adrian-dobre/Nano33IoT-Electra-Intercom/board/pcb/etch/Intercom_etch_copper_bottom.pdf

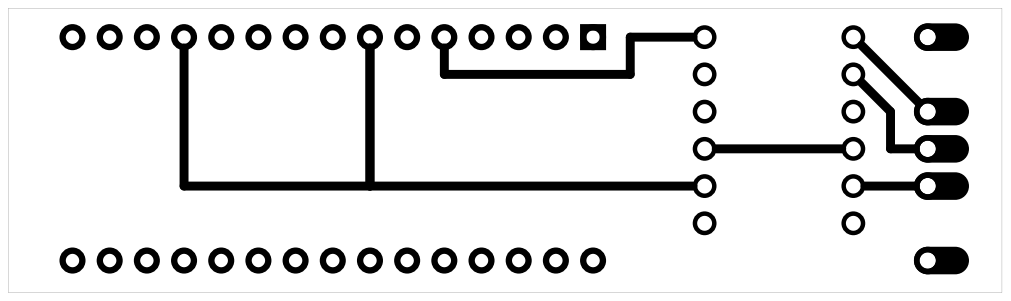
[picture p10: page 1]
