adrian-dobre/Nano33IoT-Electra-Intercom/board/pcb/etch/Intercom_etch_copper_bottom_mirror.pdf

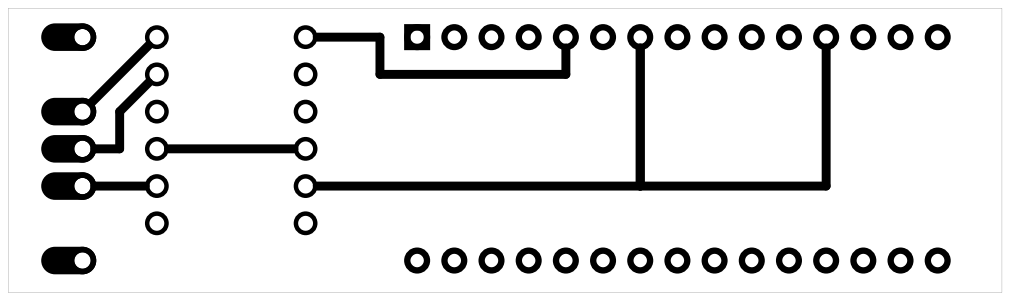
[picture p11: page 1]
