adrian-dobre/Nano33IoT-Electra-Intercom/board/pcb/etch/Intercom_etch_copper_top.pdf

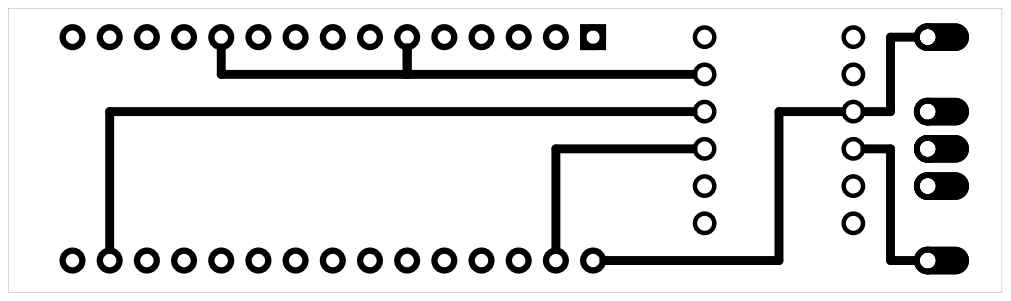
[picture p12: page 1]
