adrian-dobre/Nano33IoT-Electra-Intercom/board/pcb/etch/Intercom_etch_copper_top_mirror.pdf

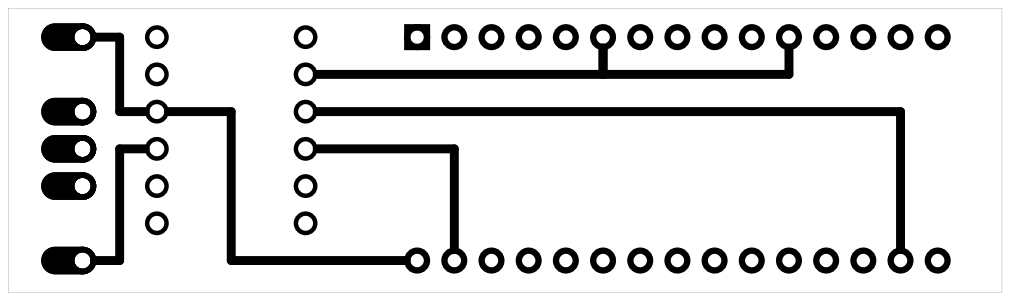
[picture p13: page 1]
