adrian-dobre/Nano33IoT-Electra-Intercom/board/pcb/etch/Intercom_etch_mask_bottom.pdf

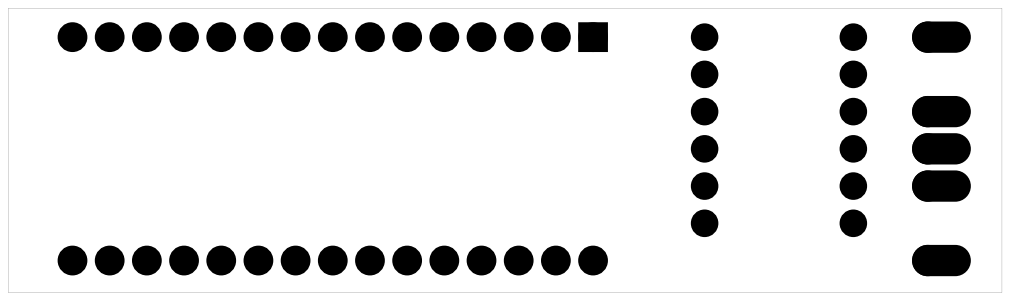
[picture p14: page 1]
