adrian-dobre/Nano33IoT-Electra-Intercom/board/pcb/etch/Intercom_etch_mask_bottom_mirror.pdf

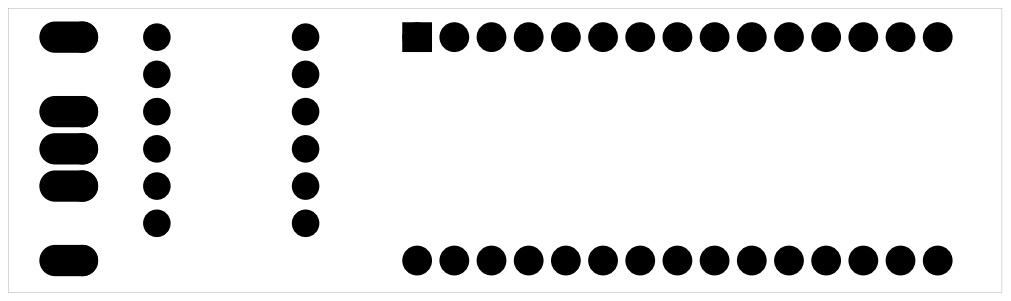
[picture p15: page 1]
