adrian-dobre/Nano33IoT-Electra-Intercom/board/pcb/etch/Intercom_etch_mask_top.pdf

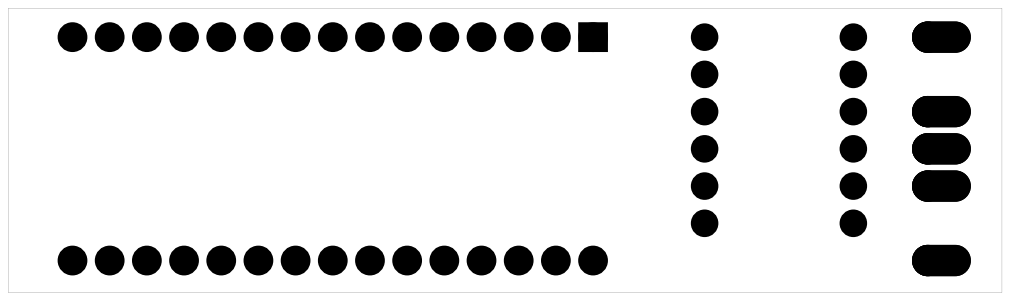
[picture p16: page 1]
