adrian-dobre/Nano33IoT-Electra-Intercom/board/pcb/etch/Intercom_etch_mask_top_mirror.pdf

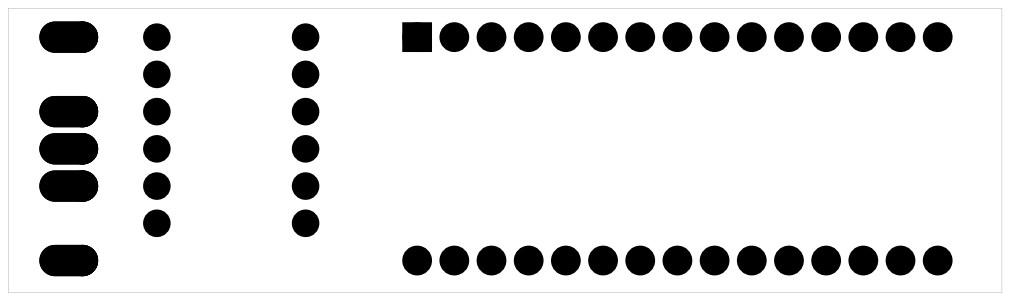
[picture p17: page 1]
