adrian-dobre/Nano33IoT-Electra-Intercom/board/pcb/etch/Intercom_etch_silk_bottom.pdf

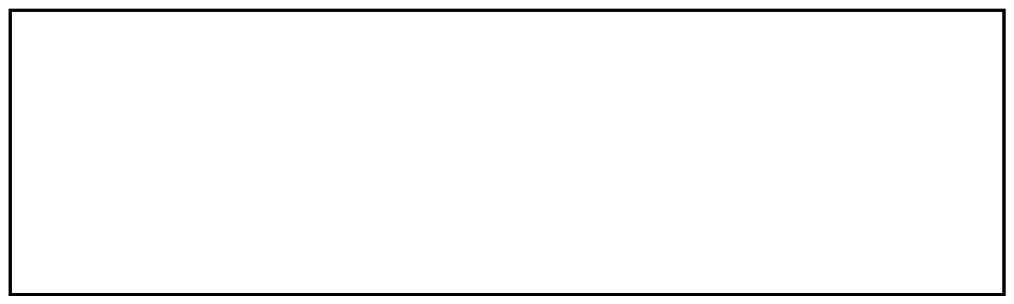
[picture p18: page 1]
