adrian-dobre/Nano33IoT-Electra-Intercom/board/pcb/etch/Intercom_etch_silk_bottom_mirror.pdf

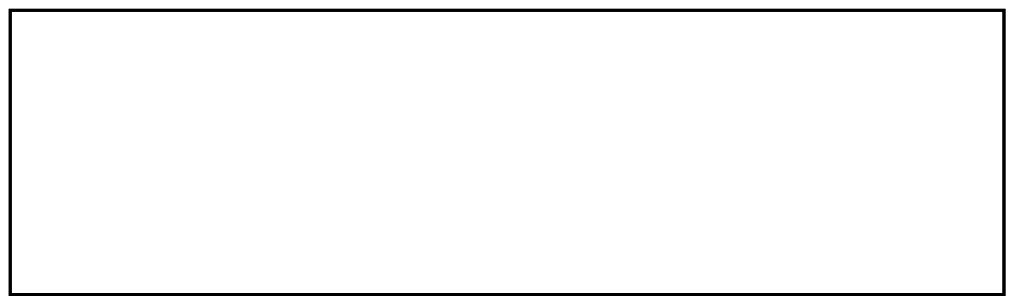
[picture p19: page 1]
