adrian-dobre/Nano33IoT-Electra-Intercom/board/pcb/etch/Intercom_etch_silk_top.pdf

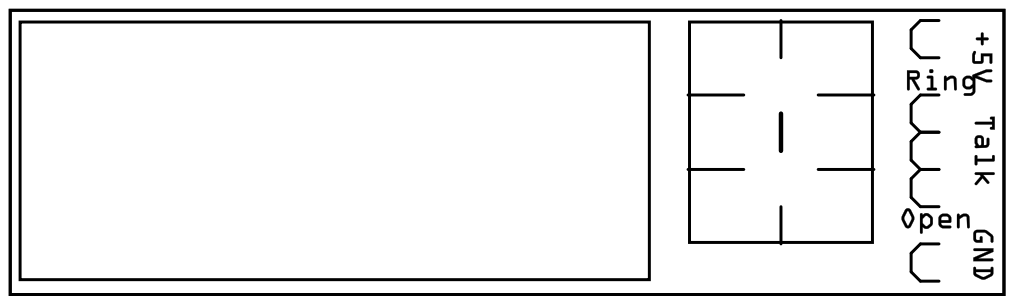
[picture p20: page 1]
