adrian-dobre/Nano33IoT-Electra-Intercom/board/pcb/etch/Intercom_etch_silk_top_mirror.pdf

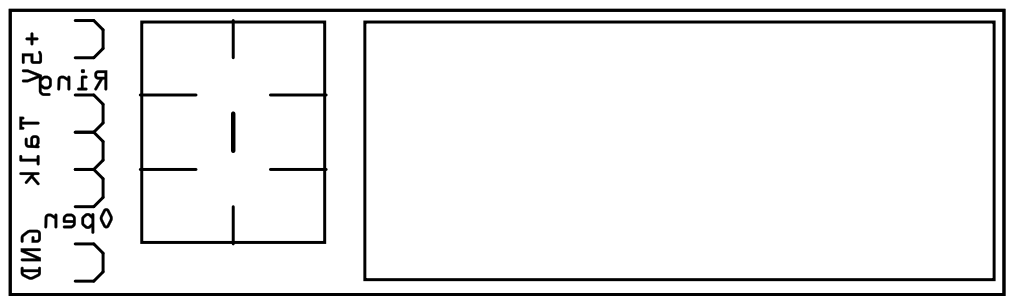
[picture p21: page 1]
