adrian-dobre/Nano33IoT-Electra-Intercom/(commit log)

2021-11-19 Configure WiFi and Web Socket connection via Web Portal
2021-11-24 add some device monitoring
2021-11-28 Add ability to report button status as well (if enabled)
